HolgiB/lenkerhalter/kugelgelenk/STL/Lenkererweiterung_Kugel.stl

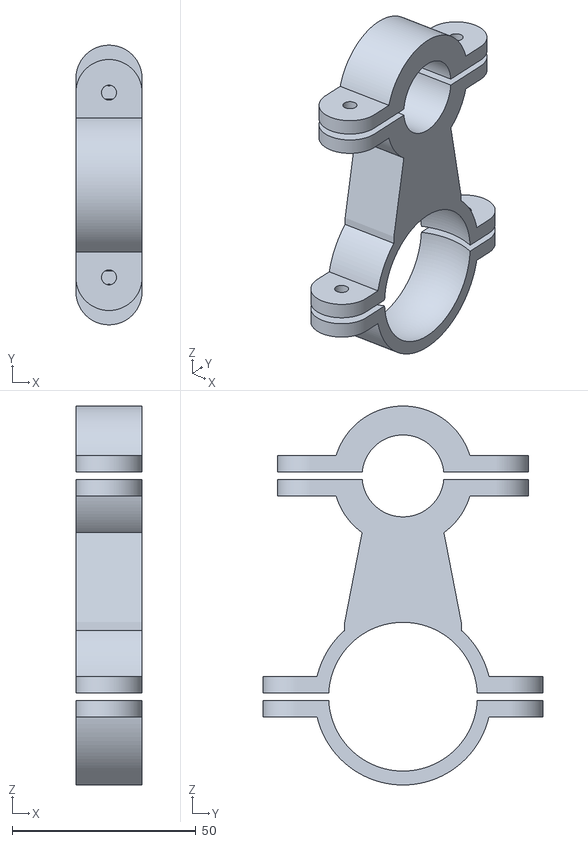
[picture p1: CAD file, 2026-10-09]
kugelgelenk/STL/Lenkererweiterung_Kugel.stl
18.0 x 76.0 x 103.0
