HolgiB/lenkerhalter/lampenhalter/STL/Lampenhalter_22mm.stl

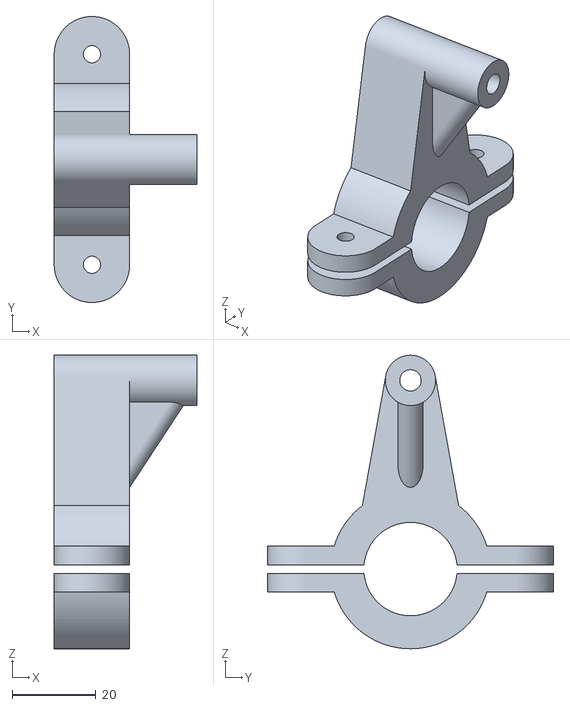
[picture p2: CAD file, 2026-10-09]
lampenhalter/STL/Lampenhalter_22mm.stl
34.0 x 68.2 x 70.0
