HolgiB/lenkerhalter/lenkererweiterung/STL/Lenkererweiterung_22mm.stl

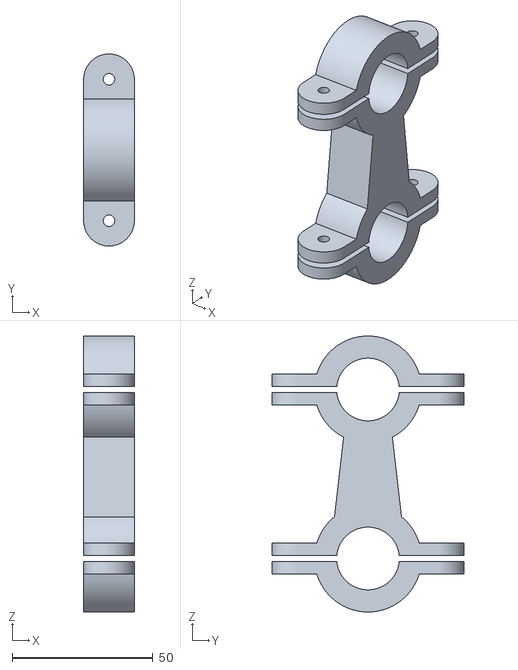
[picture p3: CAD file, 2026-10-09]
lenkererweiterung/STL/Lenkererweiterung_22mm.stl
18.0 x 68.2 x 98.0
