HolgiB/lenkerhalter/kugelgelenk/STL/Lampenhalter_Kugel.stl

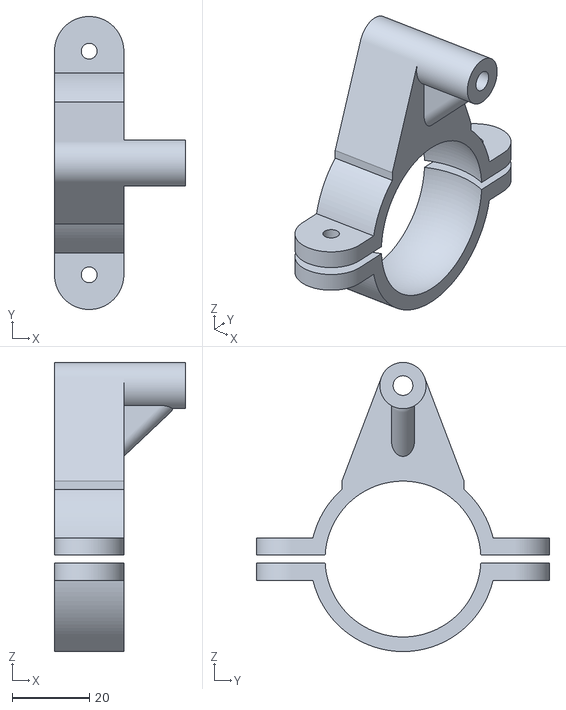
[picture p4: CAD file, 2026-10-09]
kugelgelenk/STL/Lampenhalter_Kugel.stl
34.0 x 76.0 x 75.0
