HolgiB/lenkerhalter/lampenhalter/STL/Lampenhalter_35mm.stl

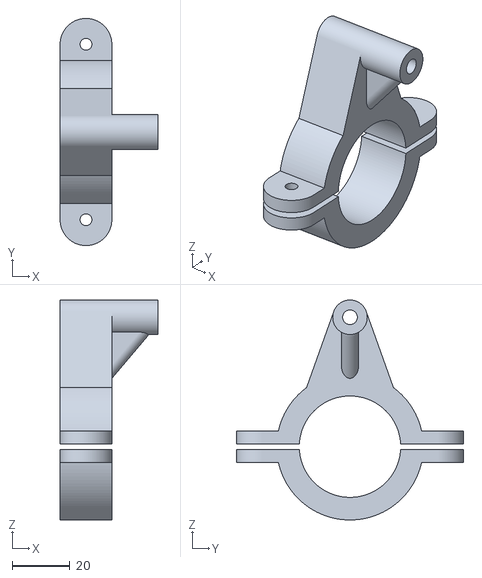
[picture p5: CAD file, 2026-10-09]
lampenhalter/STL/Lampenhalter_35mm.stl
34.0 x 79.0 x 76.5
