HolgiB/lenkerhalter/lenkererweiterung/STL/Lenkererweiterung_318mm.stl

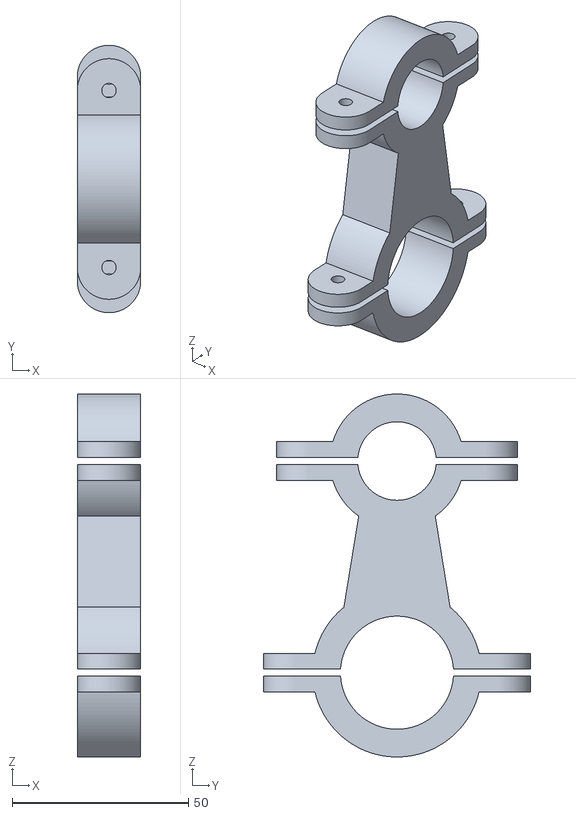
[picture p6: CAD file, 2026-10-09]
lenkererweiterung/STL/Lenkererweiterung_318mm.stl
18.0 x 75.8 x 102.9
