HolgiB/lenkerhalter/kugelgelenk/STL/Ringadapter_25-4mm.stl

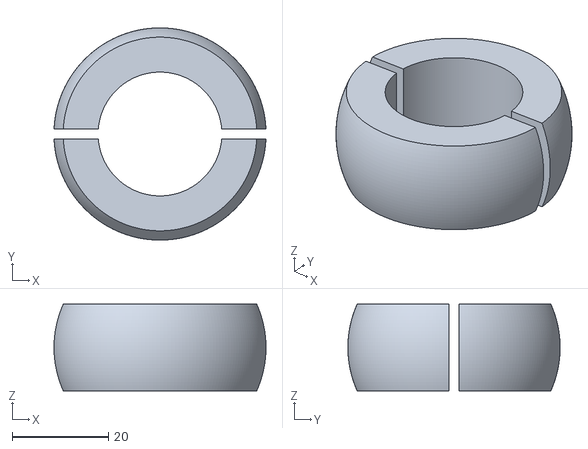
[picture p7: CAD file, 2026-10-08]
kugelgelenk/STL/Ringadapter_25-4mm.stl
43.9 x 44.0 x 18.0
