HolgiB/lenkerhalter/lenkererweiterung/STL/Lenkererweiterung_35mm.stl

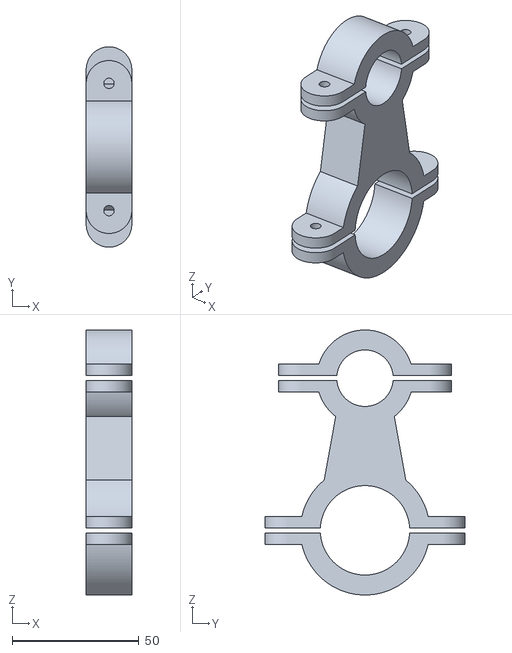
[picture p8: CAD file, 2026-10-09]
lenkererweiterung/STL/Lenkererweiterung_35mm.stl
18.0 x 79.0 x 104.5
