HolgiB/lenkerhalter/kugelgelenk/STL/Ringadapter_22mm.stl

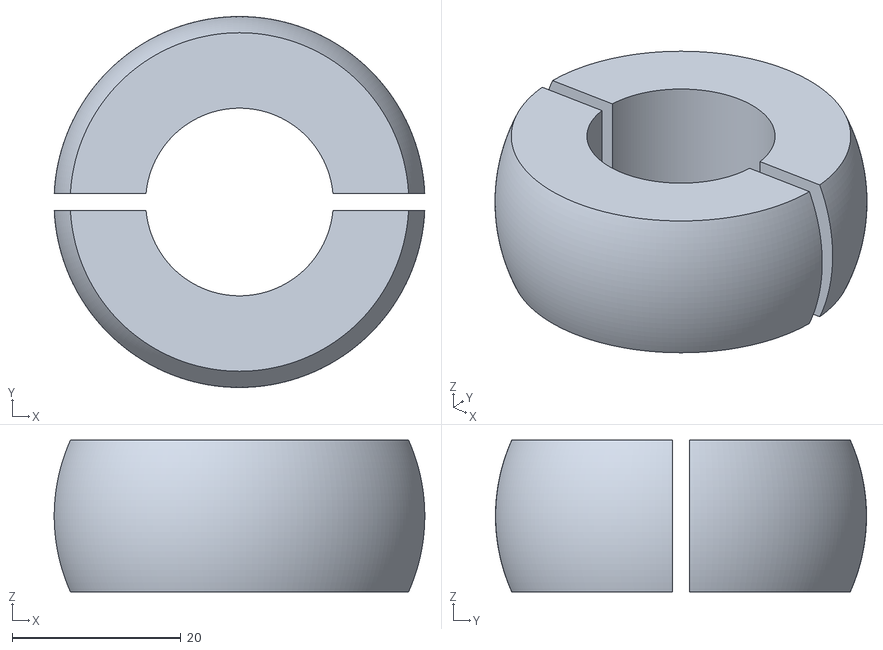
[picture p9: CAD file, 2026-10-08]
kugelgelenk/STL/Ringadapter_22mm.stl
43.9 x 44.0 x 18.0
