HolgiB/lenkerhalter/lenkererweiterung/STL/Lenkerrohr_160mm.stl

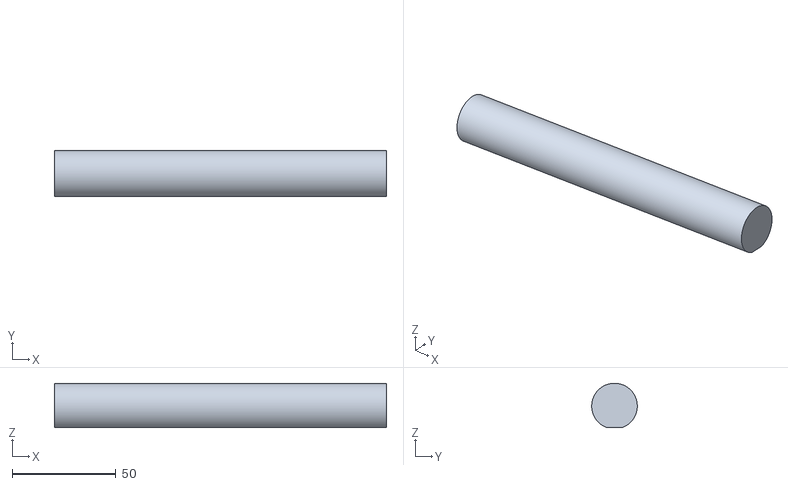
[picture p10: CAD file, 2026-10-09]
lenkererweiterung/STL/Lenkerrohr_160mm.stl
160.0 x 22.0 x 21.4
