HolgiB/lenkerhalter/kugelgelenk/STL/Ringadapter_35mm.stl

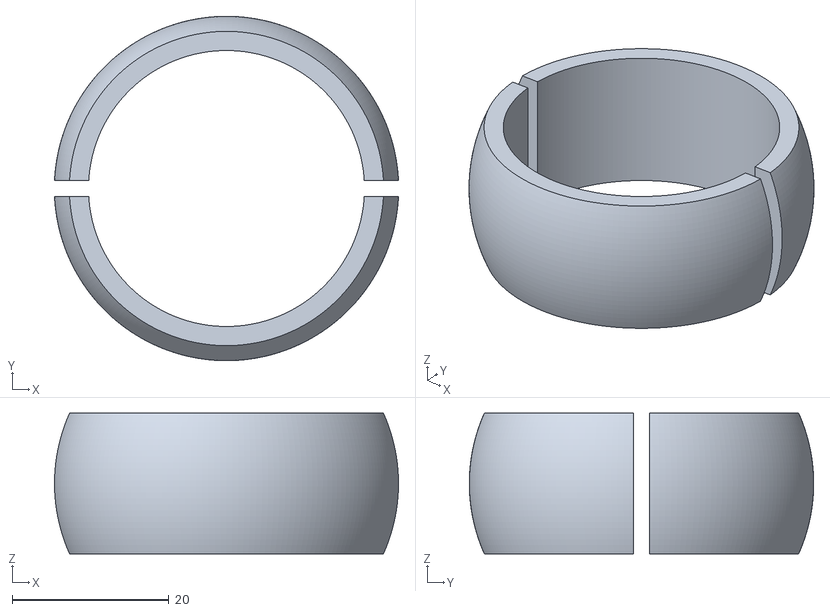
[picture p11: CAD file, 2026-10-08]
kugelgelenk/STL/Ringadapter_35mm.stl
43.9 x 44.0 x 18.0
