HolgiB/lenkerhalter/lenkererweiterung/STL/Lenkerrohr_130mm.stl

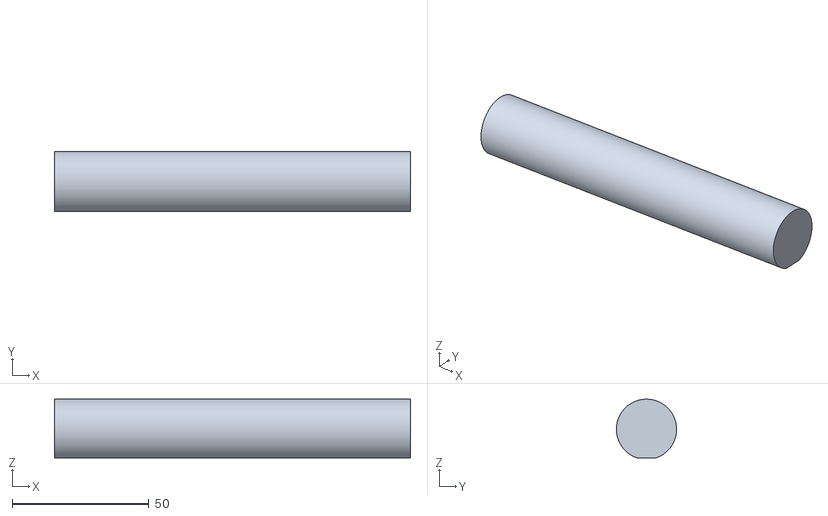
[picture p12: CAD file, 2026-10-09]
lenkererweiterung/STL/Lenkerrohr_130mm.stl
130.0 x 22.0 x 21.4
