HolgiB/lenkerhalter/kugelgelenk/STL/Ringadapter_318mm.stl

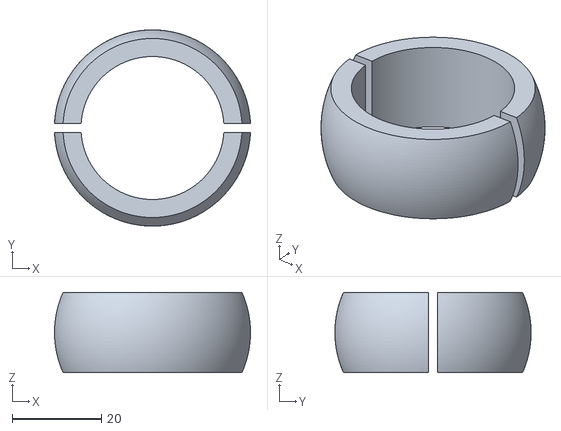
[picture p13: CAD file, 2026-10-08]
kugelgelenk/STL/Ringadapter_318mm.stl
43.9 x 44.0 x 18.0
