HolgiB/lenkerhalter/lenkererweiterung/STL/Lenkerrohr_120mm.stl

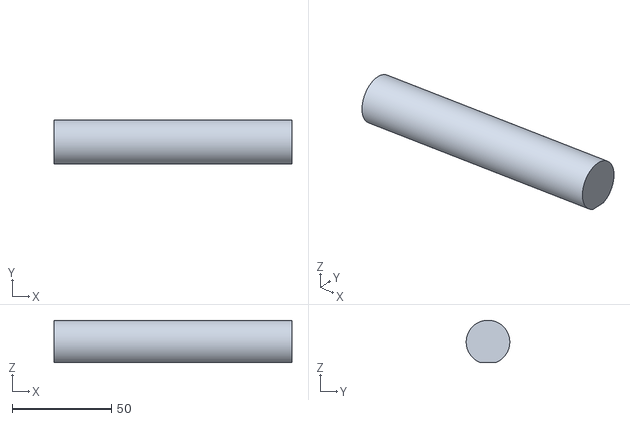
[picture p14: CAD file, 2026-10-09]
lenkererweiterung/STL/Lenkerrohr_120mm.stl
120.0 x 22.0 x 21.4
