HolgiB/lenkerhalter/(list of files, cad)

Other CAD files:
lampenhalter/STL/Lampenhalter_318mm.stl
