HolgiB/lenkerhalter/(commit log)

2026-10-08 Lenkerhalter, Lampenhalter und Kugelgelenk-Set
    [Lampenhalter_22mm.stl, Lampenhalter_318mm.stl, Lampenhalter_35mm.stl, Lampenhalter_Kugel.stl, Lenkererweiterung_22mm.stl, Lenkererweiterung_318mm.stl, Lenkererweiterung_35mm.stl, Lenkererweiterung_Kugel.stl]
2026-10-09 Lenkerrohr als Vollbauteil mit Auflageflaeche
    [Lenkerrohr_120mm.stl, Lenkerrohr_130mm.stl, Lenkerrohr_160mm.stl, lenkerrohr.scad]
2026-10-09 Armbreite exakt auf Schellenbreite: Absatz zwischen Schelle und Arm entfernt
    [Lampenhalter_22mm.stl, Lampenhalter_318mm.stl, Lampenhalter_35mm.stl, Lampenhalter_Kugel.stl, Lenkererweiterung_22mm.stl, Lenkererweiterung_318mm.stl, Lenkererweiterung_35mm.stl, Lenkererweiterung_Kugel.stl]
